ambadran/UPS/digital_design/Circuit/WhatsApp Image 2024-04-24 at 7.43.00 PM.jpeg

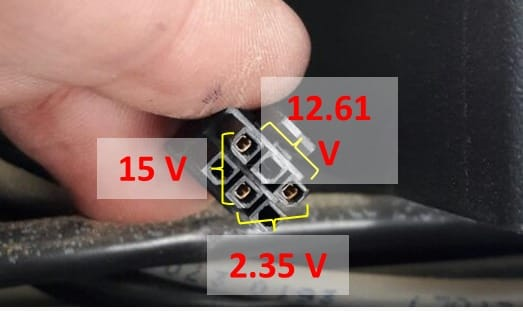
digital_design/Circuit/WhatsApp Image 2024-04-24 at 7.43.00 PM.jpeg
