ambadran/UPS/analogue_design/media/control_circuit_nand.jpeg

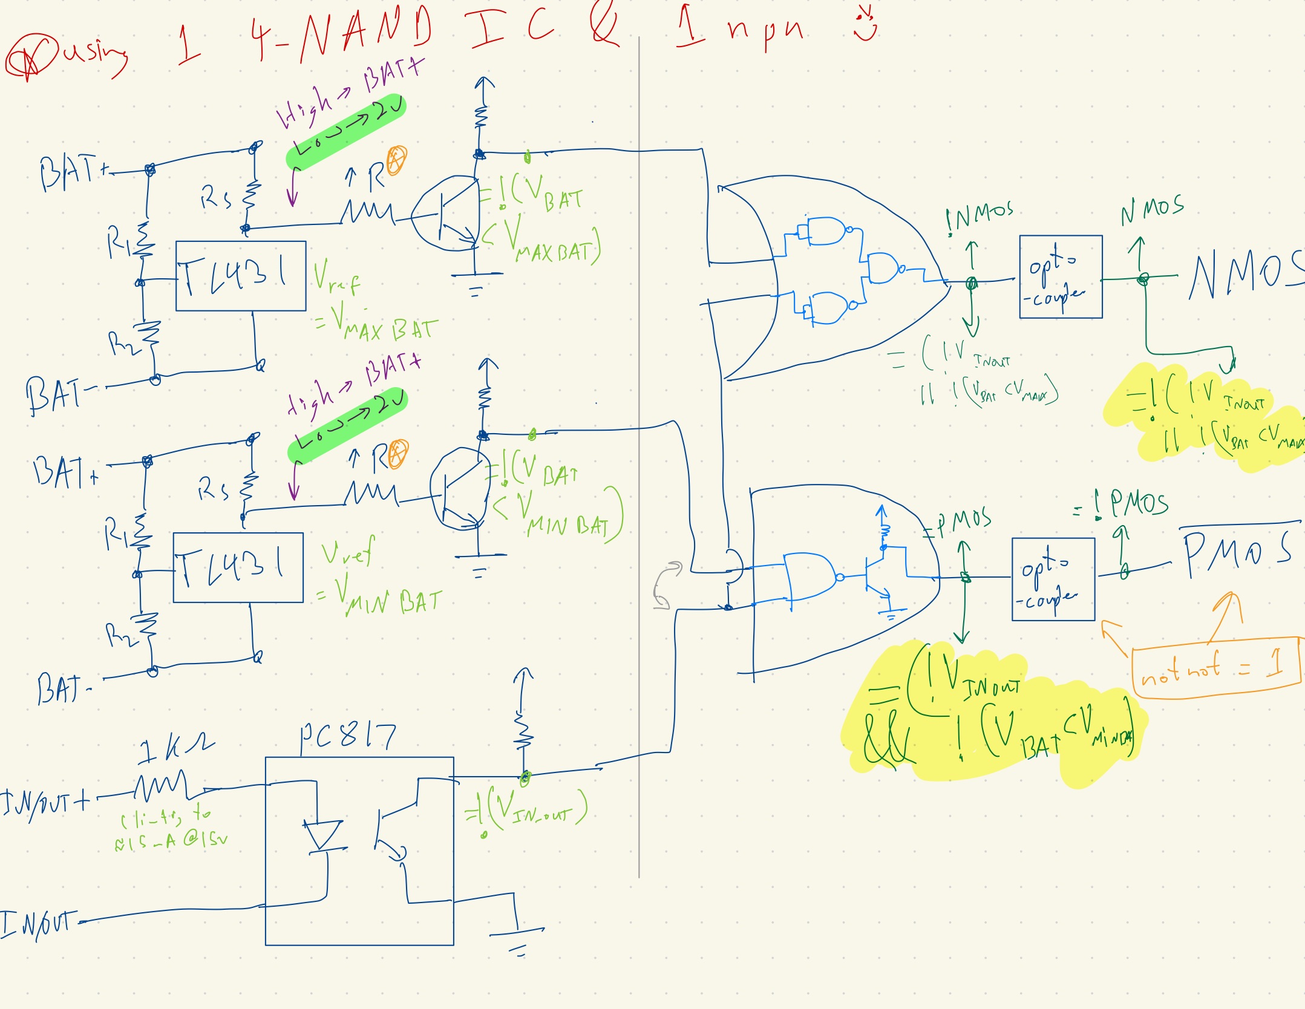
analogue_design/media/control_circuit_nand.jpeg
