ambadran/UPS/analogue_design/media/Control_circuit_npn.jpeg

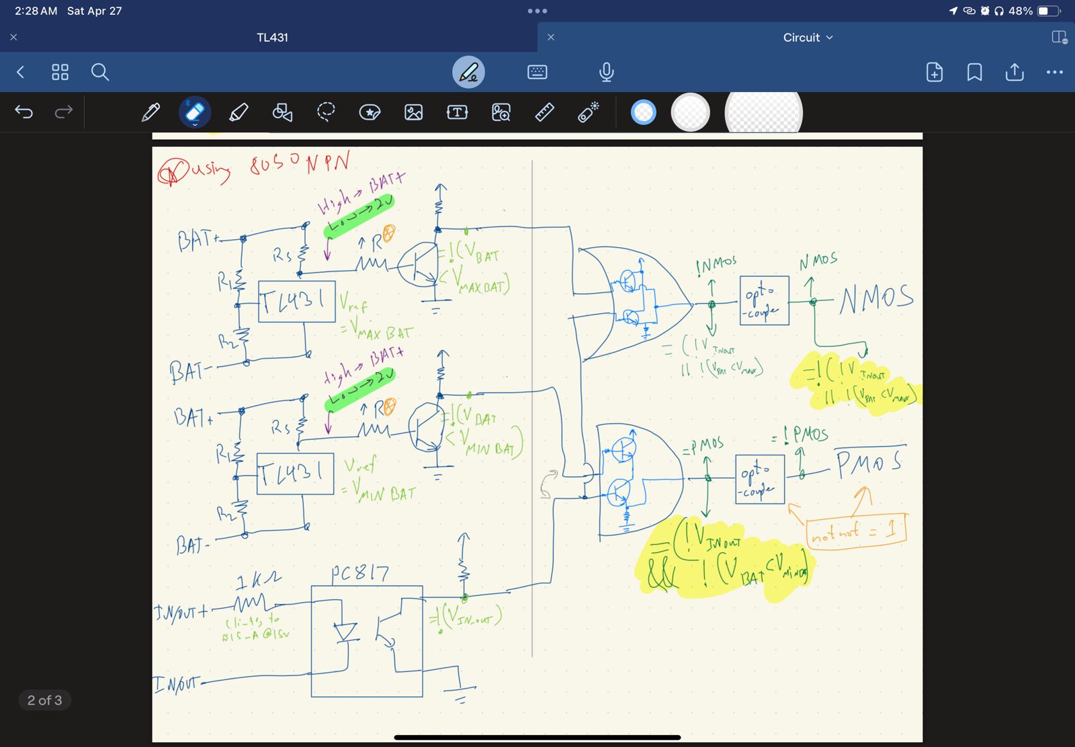
analogue_design/media/Control_circuit_npn.jpeg
