ambadran/UPS/analogue_design/media/Main Idea.png

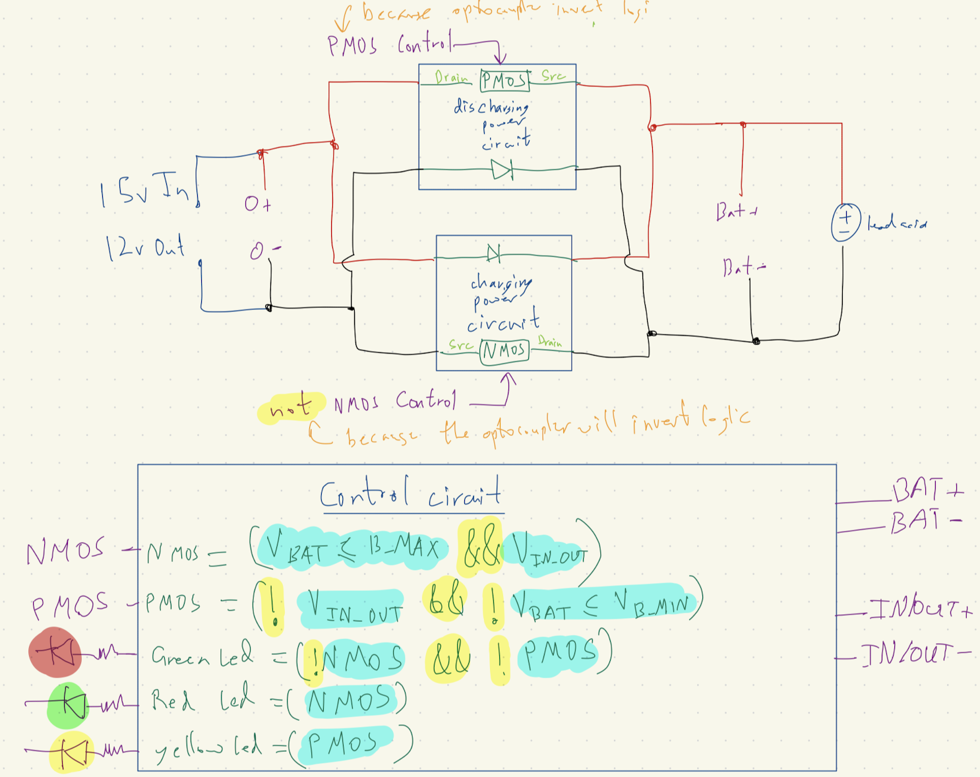
analogue_design/media/Main Idea.png
