ambadran/UPS/analogue_design/media/WhatsApp Image 2024-04-29 at 7.11.07 PM.jpeg

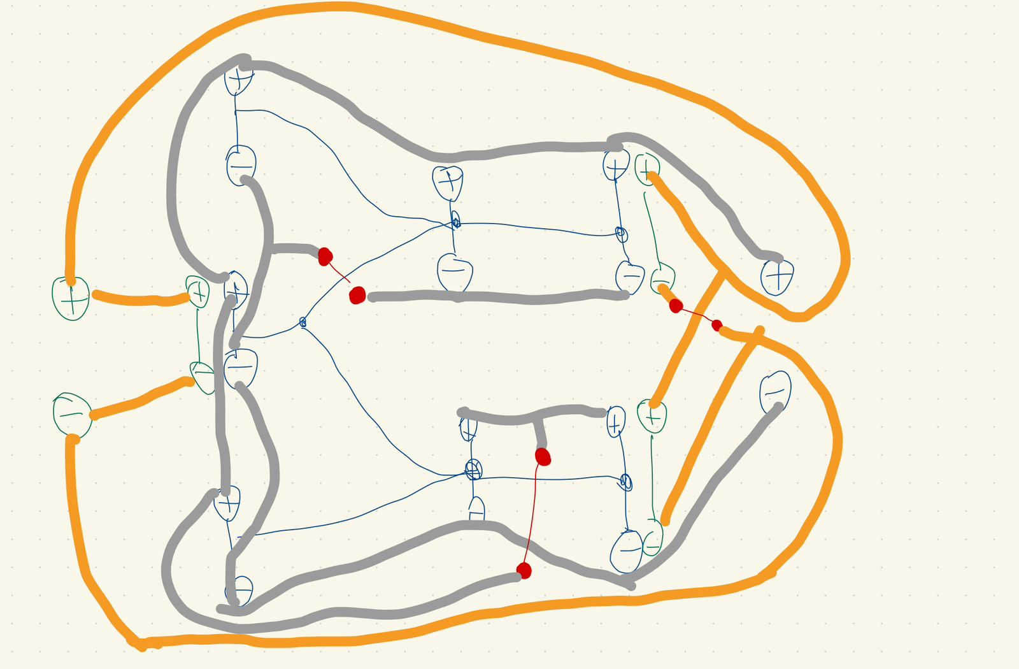
analogue_design/media/WhatsApp Image 2024-04-29 at 7.11.07 PM.jpeg
