ambadran/UPS/digital_design/Circuit/BOM/Board_BOM.xlsx

Sheet: One PCB
No. | Name | Cost | Quantity | Total Cost | Description | Store
1 | PCB board | 130 | 1 | 130
2 | IRFZ44n | 0 | 1 | 0 | ALREADY BOUGHT
3 | IRF9540 | 35 | 1 | 35 |  | RAM
4 | PC817 | 3 | 5 | 15 |  | UGE
5 | Resistor | 1 | 12 | 12 | 330 x6, 1K x3, 20k x1, 10k x1
6 | LM7805 | 1 | 8 | 8 |  | UGE
7 | Capacitor electrolytic | 2 | 1 | 2 | 10uf
8 | Capacitor ceramic | 1 | 1 | 1 | 10nf
9 | STC15W408AS DIP16 | 51 | 1 | 51
10 | RJ45 | 20 | 2 | 40 |  | fares
11 | RGB led | 5 | 1 | 5 |  | UGE
12 | RGB 3d printed mount | 15 | 1 | 15 | 3d printed
13 | 10 turn pot 500ohm | 10 | 1 | 10
14 | SR360 | 3 | 2 | 6 |  | future
15 | 1mm power wires/m | 6 | 0.3 | 1.8 | for battery output and led extension
16 | Pin Headers | 5 | 1 | 5 | for debug pins
17 | Power pin header 3d printed | 10 | 1 | 10
18 | female pin header E508 | 1 | 3 | 3
19 | 6-pin 3d printed connector | 20 | 2 | 40
20 | Battery crimp terminals | 3 | 2 | 6
 | TOTAL |  |  | 395.8

Sheet: Sheet1
No. | Name | Cost | Quantity | Total Cost | Description | Store
1 | Complete Soldered PCB | 395.8 | 17 | 6728.6
 |  |  |  | 0
<> | Design, testing and manufacturing | 6000 | 1 | 6000
 | TOTAL |  |  | 12728.6
