ambadran/UPS/digital_design/Circuit/BOM/Total.xlsx

No. | Name | Cost | Quantity | Total Cost
1 | Complete PCB | 395.8 | 17 | 6728.6
<> | Design, Testing and manufacturing | 35 | 1 | 7000
 | TOTAL |  |  | 13728.6
