ambadran/UPS/analogue_design/PDF/back.pdf

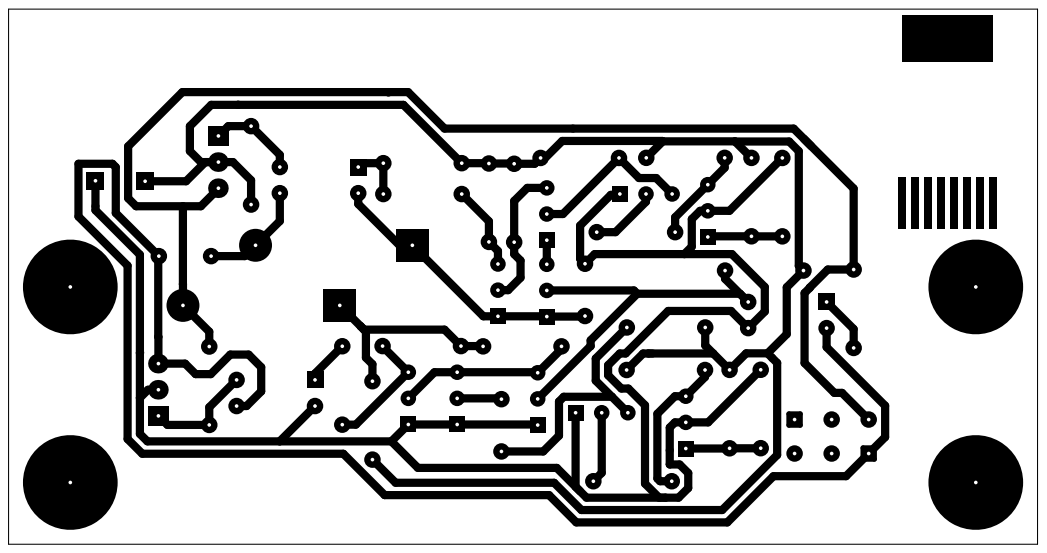
[picture p6: page 1]
