ambadran/UPS/analogue_design/PDF/front.pdf

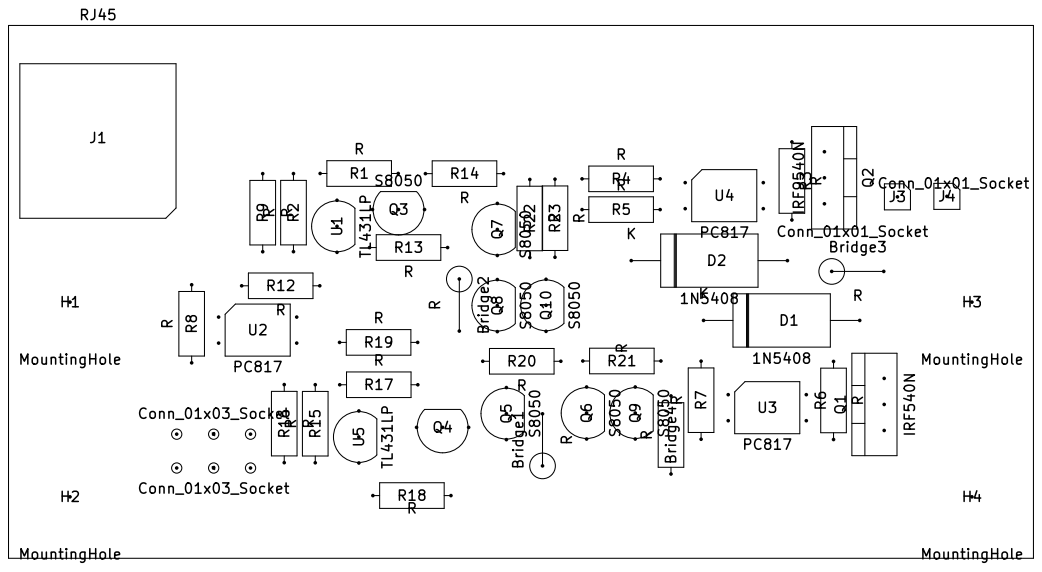
[picture p7: page 1]
