ambadran/UPS/digital_design/Circuit/PDF/back.pdf

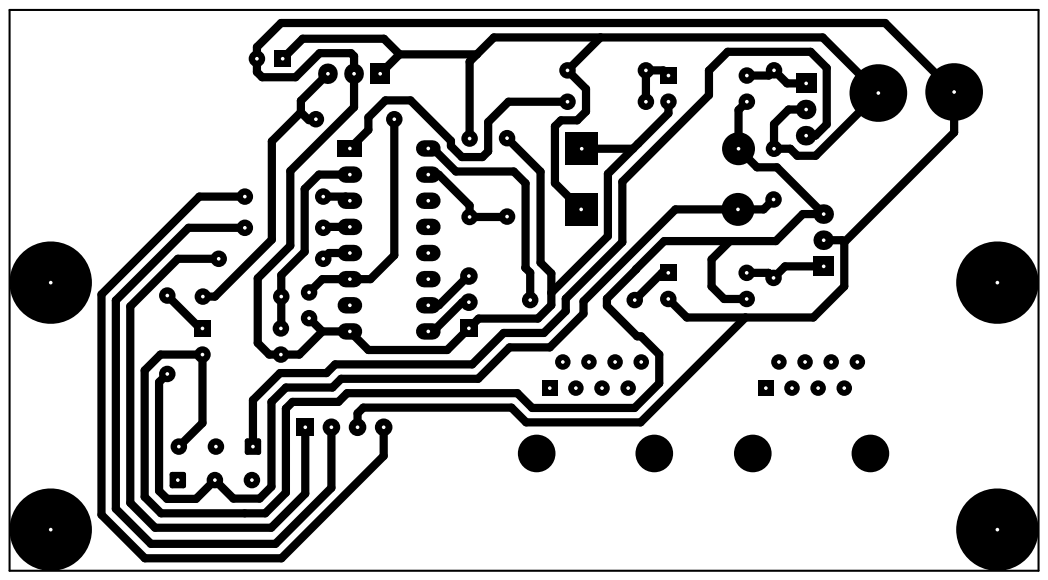
[picture p8: page 1]
