ambadran/UPS/digital_design/Circuit/PDF/front.pdf

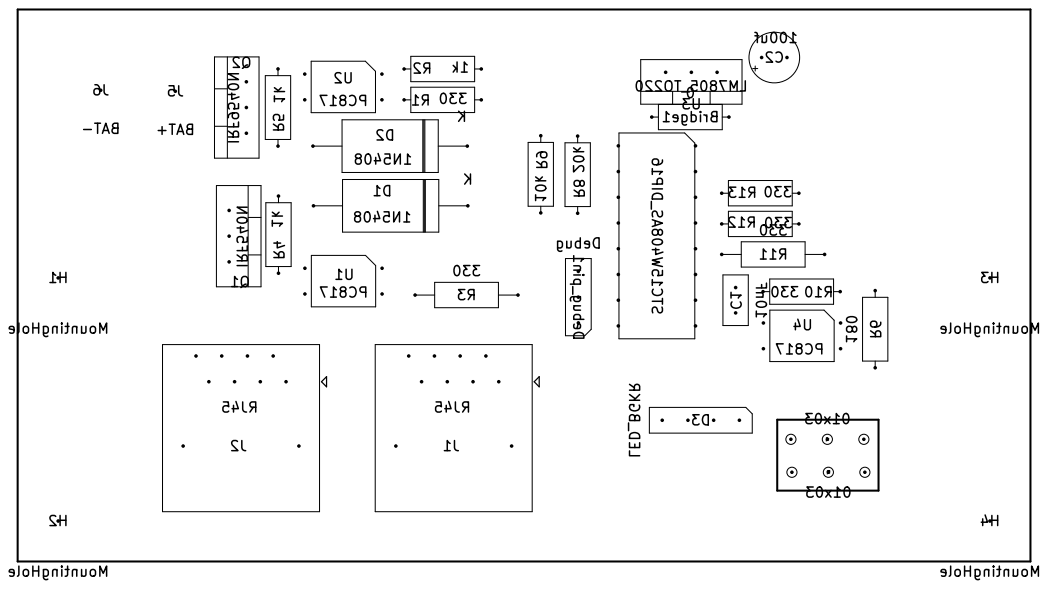
[picture p9: page 1]
