ambadran/UPS/digital_design/Circuit/PDF/ups.pdf

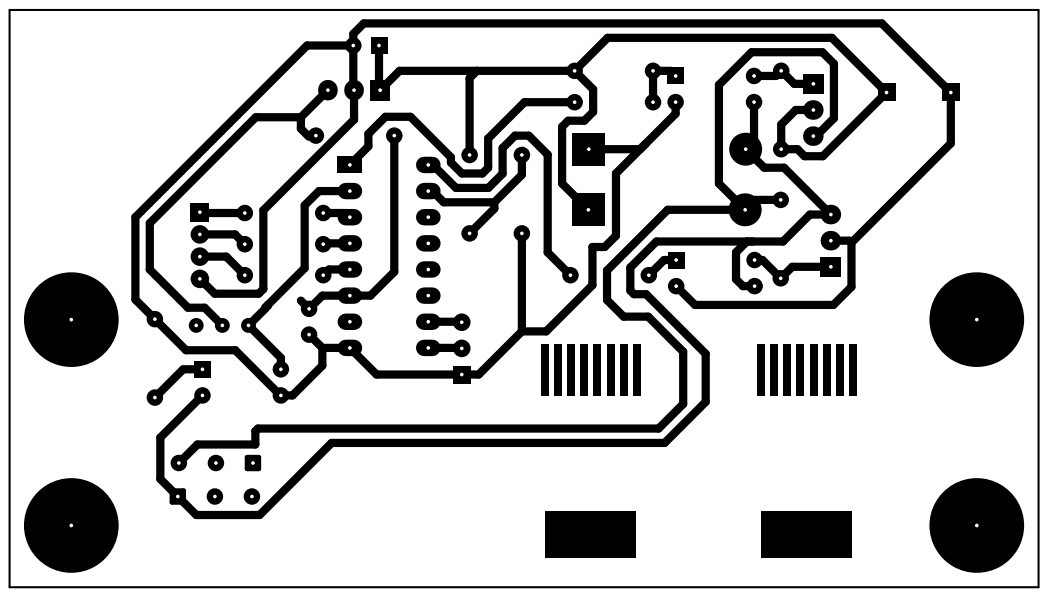
[picture p10: page 1]
