ambadran/UPS/digital_design/Circuit/Circuit.kicad_pcb

## KiCad design digital_design/Circuit/Circuit.kicad_pcb (2024-08-04)

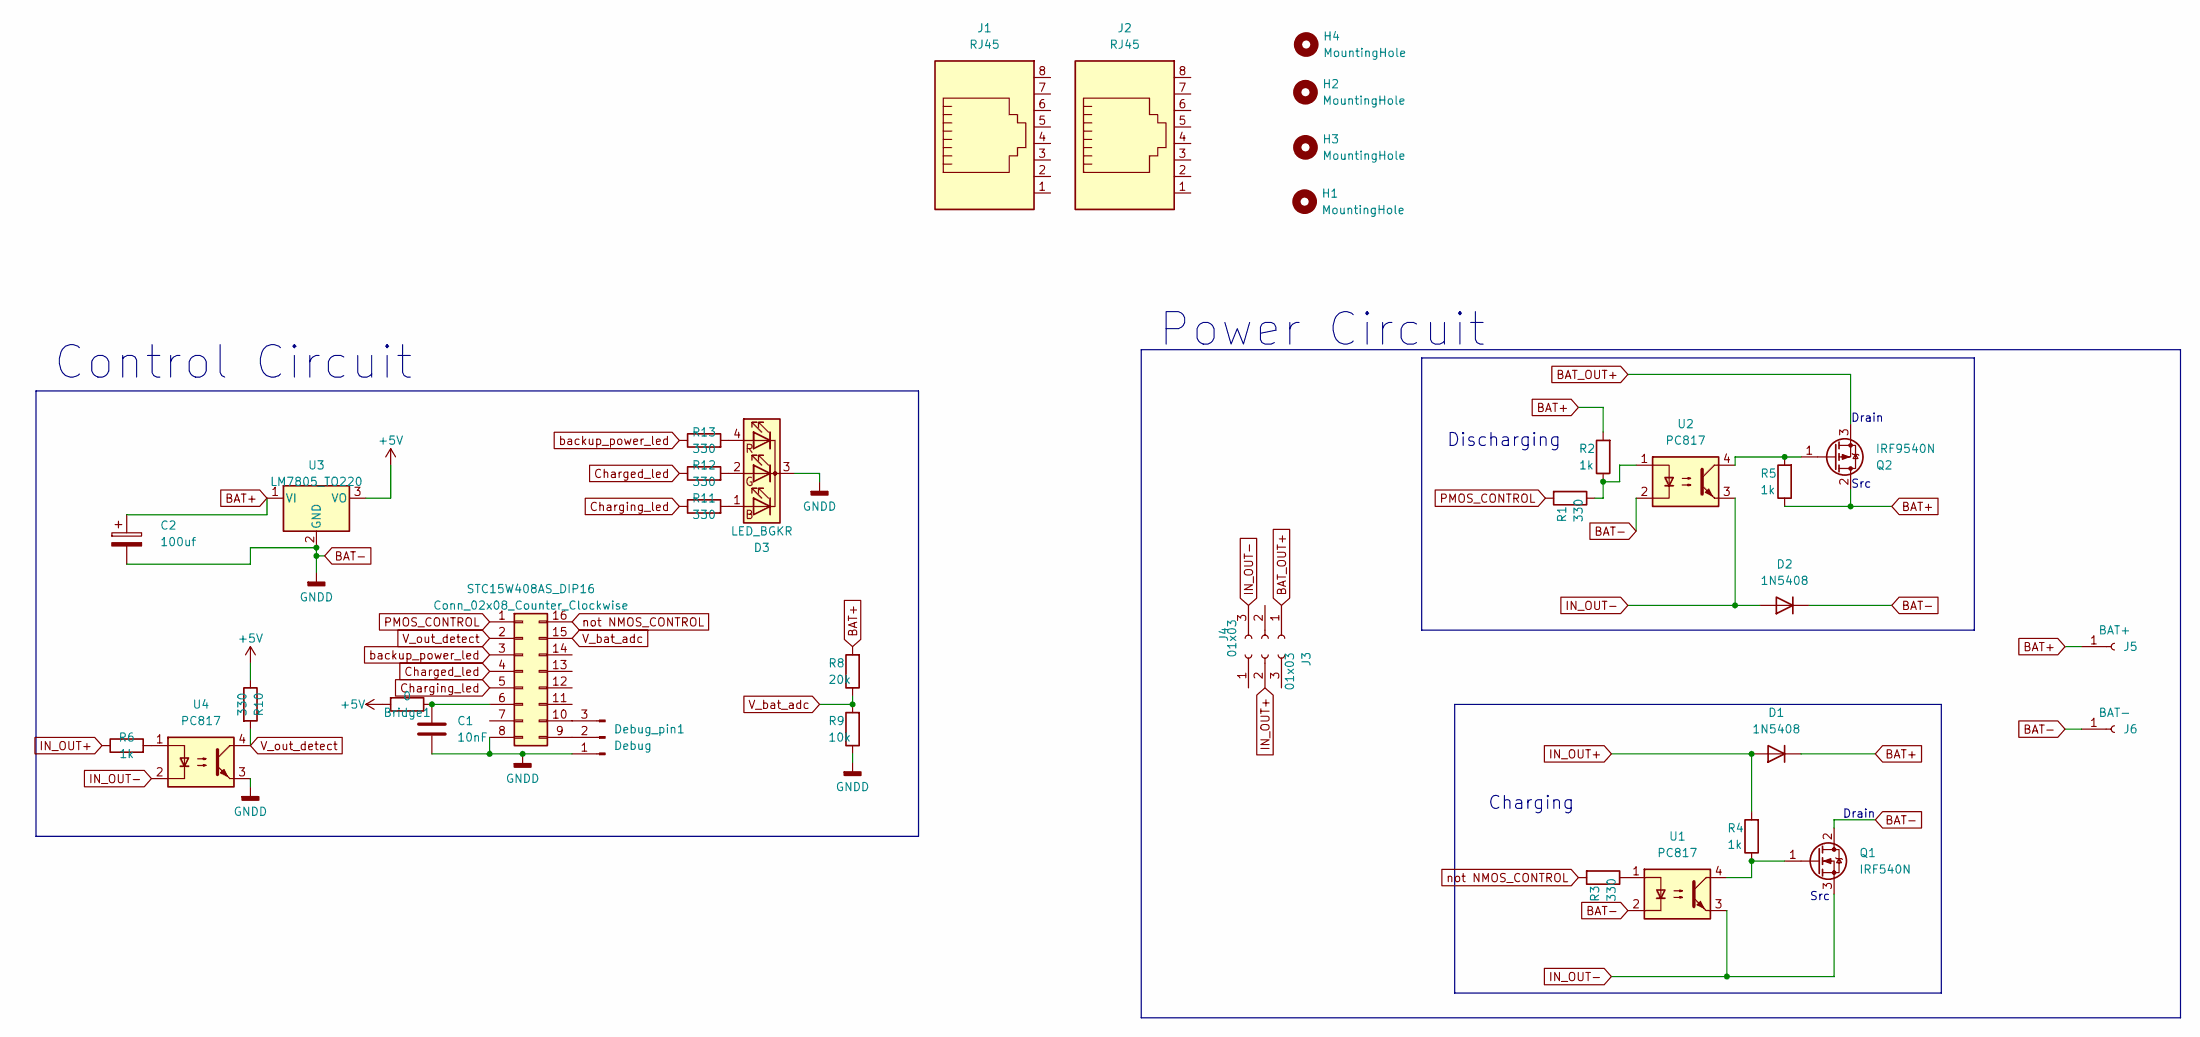
[picture p11: schematic Circuit.kicad_sch]

Parts:
Bridge1: 0; R_Axial_DIN0207_L6.3mm_D2.5mm_P7.62mm_Horizontal
C1: 10nF; C_Disc_D5.0mm_W2.5mm_P2.50mm
C2: 100uf; CP_Radial_D5.0mm_P2.50mm
D1, D2: 1N5408; D_DO-201AD_P15.24mm_Horizontal
D3: LED_BGKR; PinSocket_1x04_P2.54mm_Vertical
Debug_pin1: Debug; PinSocket_1x03_P2.54mm_Vertical
H1, H2, H3, H4: MountingHole; MountingHole_4mm_Pad_TopBottom
J1, J2: RJ45; RJ45_OST_PJ012-8P8CX_Vertical
J3, J4: 01x03; SolderWire-0.1sqmm_1x03_P3.6mm_D0.4mm_OD1mm
J5: BAT+; MountingHole_3.2mm_M3_DIN965_Pad_TopBottom
J6: BAT-; MountingHole_3.2mm_M3_DIN965_Pad_TopBottom
Q1: IRF540N; TO-220-3_Vertical
Q2: IRF9540N; TO-220-3_Vertical
R1, R10, R12, R13: 330; R_Axial_DIN0207_L6.3mm_D2.5mm_P7.62mm_Horizontal
R2, R4, R5, R6: 1k; R_Axial_DIN0207_L6.3mm_D2.5mm_P7.62mm_Horizontal
R3, R11: 330; R_Axial_DIN0207_L6.3mm_D2.5mm_P10.16mm_Horizontal
R8: 20k; R_Axial_DIN0207_L6.3mm_D2.5mm_P7.62mm_Horizontal
R9: 10k; R_Axial_DIN0207_L6.3mm_D2.5mm_P7.62mm_Horizontal
STC15W408AS_DIP16: Conn_02x08_Counter_Clockwise; CERDIP-16_W7.62mm_SideBrazed_LongPads
U1, U2, U4: PC817; DIP-4_W7.62mm
U3: LM7805_TO220; TO-220-3_Vertical

Connections:
+5V: Bridge1.2, R10.1, U3.3 (VO)
BAT+: C2.1, D1.1 (K), J5.1, Q2.2 (D), R2.2, R5.1, R8.2, U3.1 (VI)
BAT-: C1.2, C2.2, D2.1 (K), D3.3 (K), Debug_pin1.1, J6.1, Q1.2 (D), R9.1, STC15W408AS_DIP16.8, U1.2, U2.2, U3.2 (GND), U4.3
BAT_OUT+: J4.1, Q2.3 (S)
Charged_led: R12.1, STC15W408AS_DIP16.4
Charging_led: R11.1, STC15W408AS_DIP16.5
IN_OUT+: D1.2 (A), J3.2, R4.2, R6.1
IN_OUT-: D2.2 (A), J4.3, Q1.3 (S), U1.3, U2.3, U4.2
unnamed: D3.1 (BA), R11.2
unnamed: D3.2 (GA), R12.2
unnamed: D3.4 (RA), R13.2
unnamed: Debug_pin1.2, STC15W408AS_DIP16.9
unnamed: Debug_pin1.3, STC15W408AS_DIP16.10
unnamed: Q1.1 (G), R4.1, U1.4
unnamed: Q2.1 (G), R5.2, U2.4
unnamed: R1.1, R2.1, U2.1
unnamed: R3.1, U1.1
unnamed: R6.2, U4.1
unnamed: Bridge1.1, C1.1, STC15W408AS_DIP16.6
PMOS_CONTROL: R1.2, STC15W408AS_DIP16.1
V_bat_adc: R8.1, R9.2, STC15W408AS_DIP16.15
V_out_detect: R10.2, STC15W408AS_DIP16.2, U4.4
backup_power_led: R13.1, STC15W408AS_DIP16.3
not NMOS_CONTROL: R3.2, STC15W408AS_DIP16.16

Notes on the sheet:
Src
Power Circuit
Drain
Control Circuit
Discharging
Charging

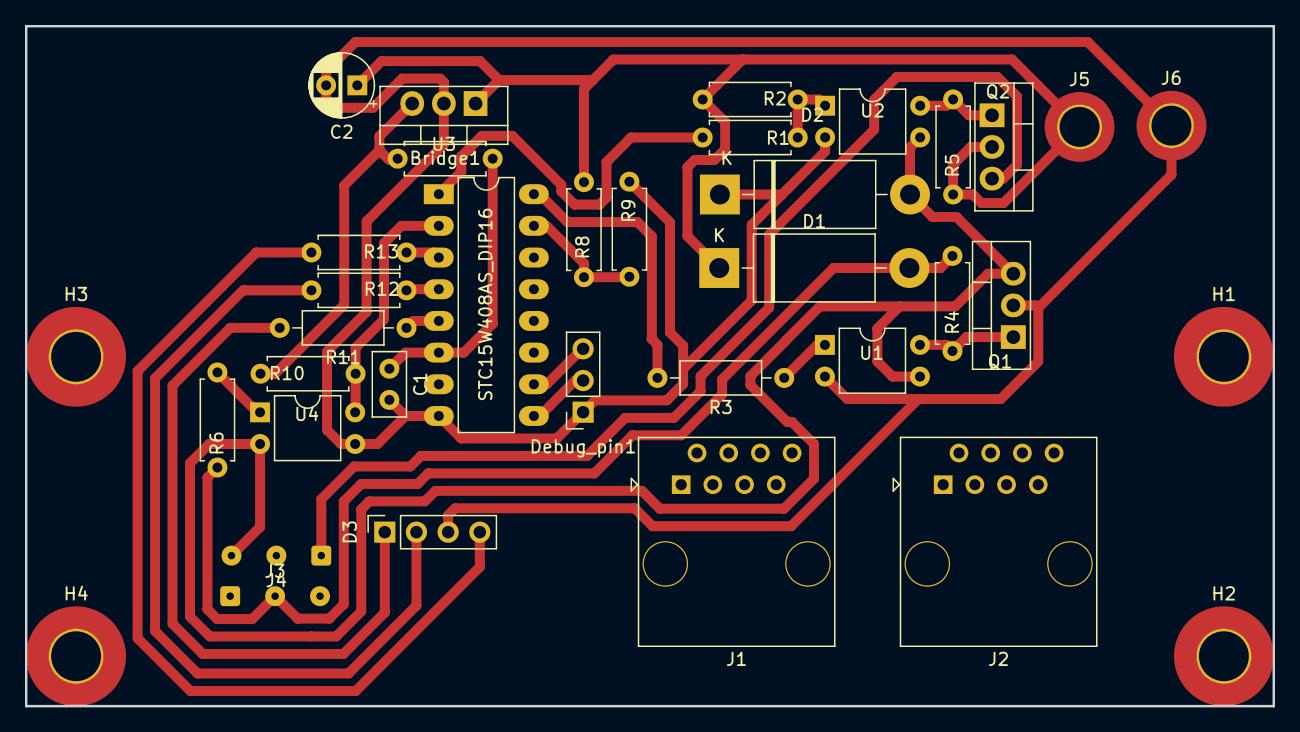
[picture p12: board Circuit.kicad_pcb from above]

Board: 2 copper layers, 100.0 x 54.5 mm, 36 parts (0 on the bottom side), 24 nets.
