ambadran/UPS/analogue_design/auto_cutoff_battery.kicad_pcb

## KiCad design analogue_design/auto_cutoff_battery.kicad_pcb (2024-05-02)

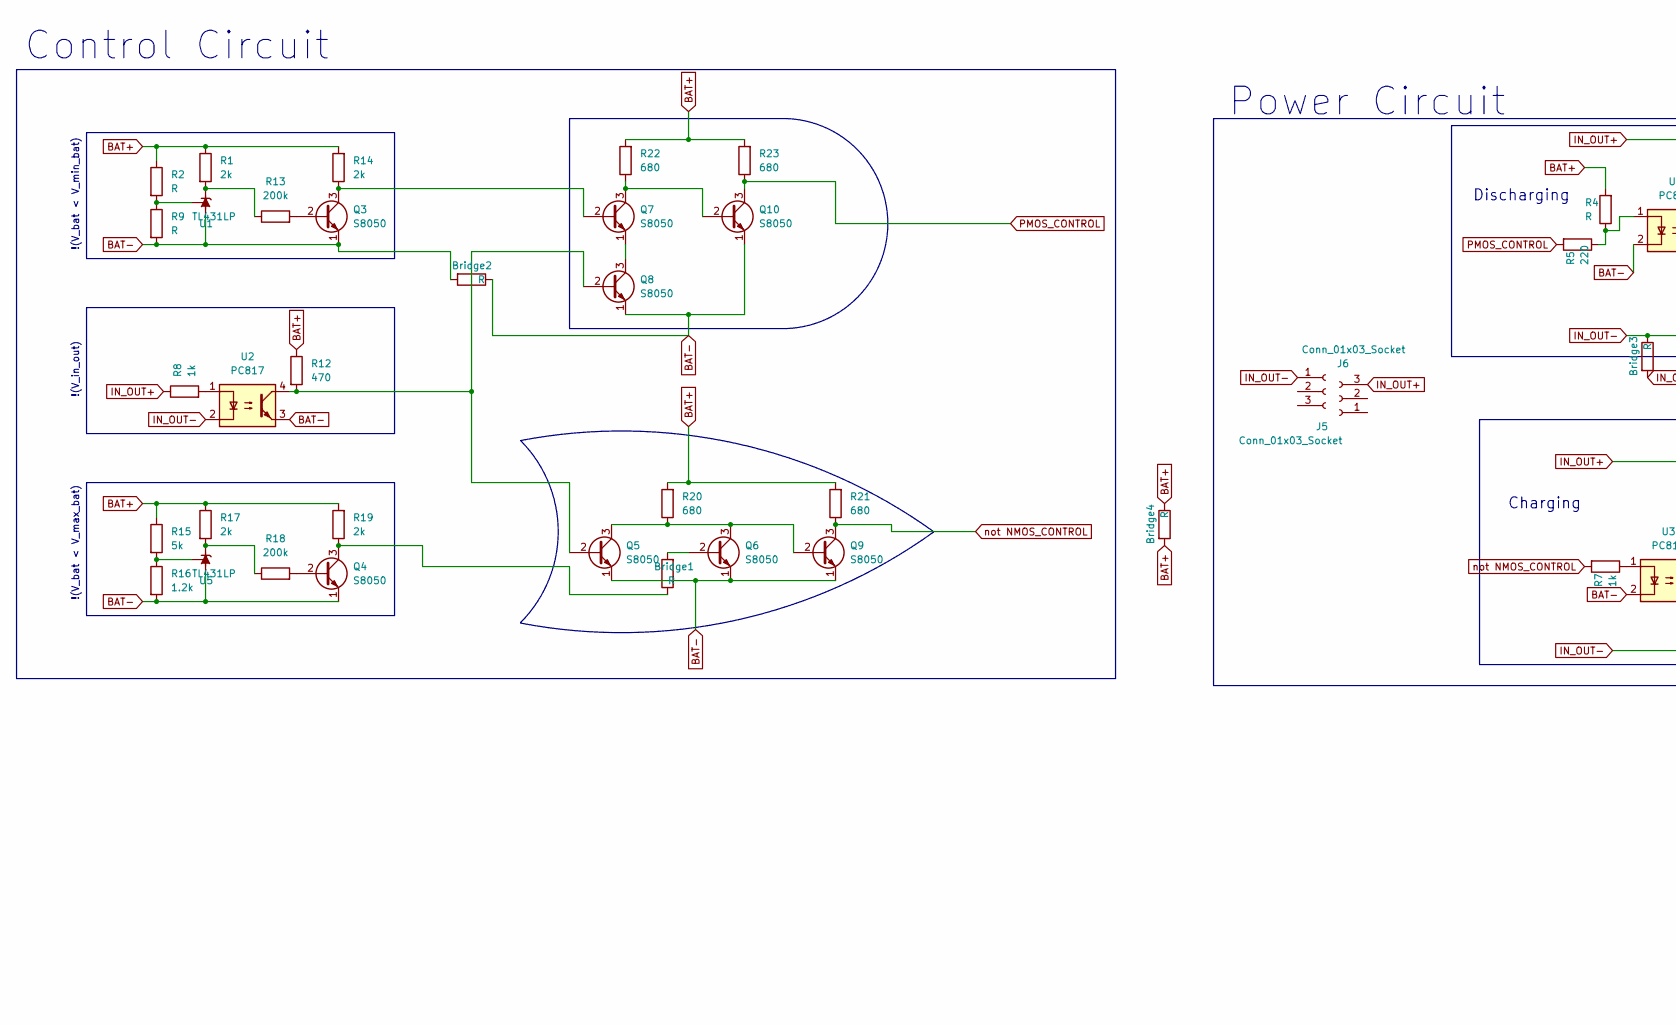
[picture p13: schematic auto_cutoff_battery.kicad_sch, part in row 1, column 1]

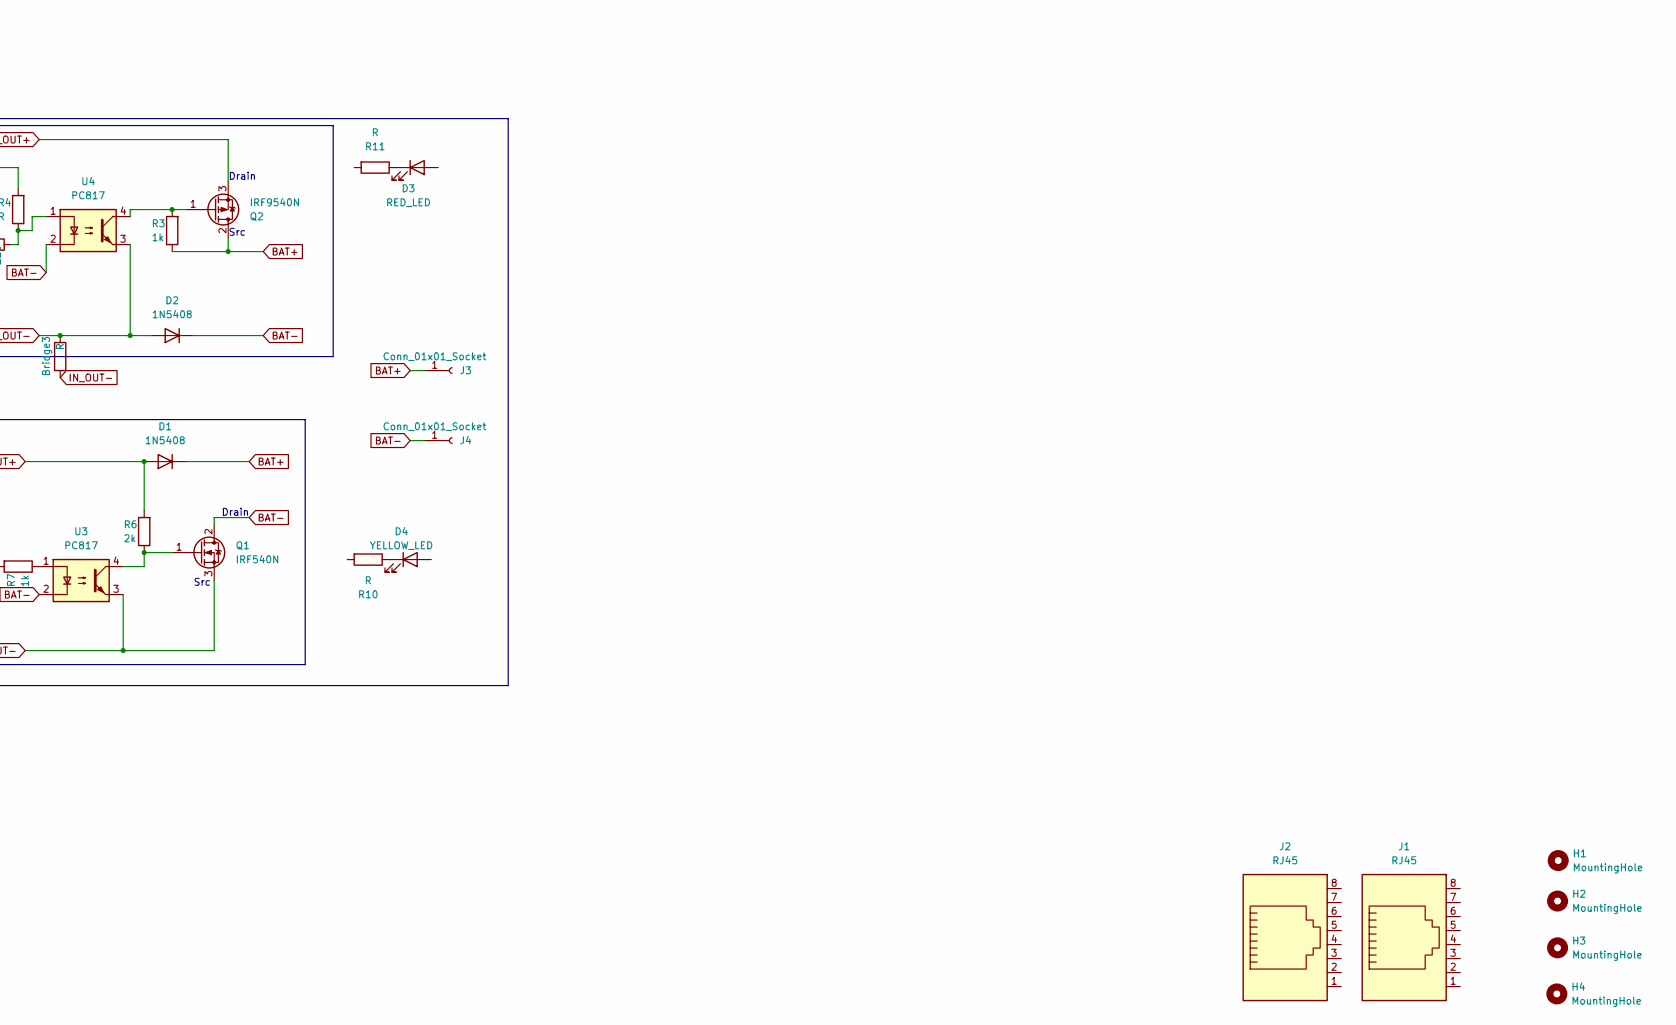
[picture p14: schematic auto_cutoff_battery.kicad_sch, part in row 1, column 2]

Parts:
Bridge1, Bridge2, Bridge3: R; R_Axial_DIN0207_L6.3mm_D2.5mm_P5.08mm_Vertical
Bridge4: R; R_Axial_DIN0207_L6.3mm_D2.5mm_P7.62mm_Horizontal
D1, D2: 1N5408; D_DO-201AD_P15.24mm_Horizontal
D3: RED_LED; LED_D3.0mm
D4: YELLOW_LED; LED_D3.0mm
H1, H2, H3, H4: MountingHole; MountingHole_5.3mm_M5_DIN965_Pad
J1, J2: RJ45; RJ45_Molex_0855135013_Vertical
J3, J4: Conn_01x01_Socket; PinSocket_1x01_P2.54mm_Vertical
J5, J6: Conn_01x03_Socket; SolderWire-0.1sqmm_1x03_P3.6mm_D0.4mm_OD1mm
Q1: IRF540N; TO-220-3_Vertical
Q2: IRF9540N; TO-220-3_Vertical
Q3, Q4, Q5, Q6, Q7, Q8, Q9, Q10: S8050; TO-92_Inline_Wide
R1, R6, R14, R17, R19: 2k; R_Axial_DIN0207_L6.3mm_D2.5mm_P7.62mm_Horizontal
R2, R4, R9, R10, R11: R; R_Axial_DIN0207_L6.3mm_D2.5mm_P7.62mm_Horizontal
R3, R7, R8: 1k; R_Axial_DIN0207_L6.3mm_D2.5mm_P7.62mm_Horizontal
R5: 220; R_Axial_DIN0207_L6.3mm_D2.5mm_P7.62mm_Horizontal
R12: 470; R_Axial_DIN0207_L6.3mm_D2.5mm_P7.62mm_Horizontal
R13, R18: 200k; R_Axial_DIN0207_L6.3mm_D2.5mm_P7.62mm_Horizontal
R15: 5k; R_Axial_DIN0207_L6.3mm_D2.5mm_P7.62mm_Horizontal
R16: 1.2k; R_Axial_DIN0207_L6.3mm_D2.5mm_P7.62mm_Horizontal
R20, R21, R22, R23: 680; R_Axial_DIN0207_L6.3mm_D2.5mm_P7.62mm_Horizontal
U1, U5: TL431LP; TO-92_Inline_Wide
U2, U3, U4: PC817; DIP-4_W7.62mm

Connections:
BAT+: Bridge4.1, Bridge4.2, D1.1 (K), J3.1, Q2.2 (D), R1.1, R2.1, R3.1, R4.2, R12.1, R14.2, R15.1, R17.1, R19.2, R20.2, R21.2, R22.2, R23.2
BAT-: Bridge2.1, Bridge2.2, D2.1 (K), J4.1, Q1.2 (D), Q3.1 (E), Q4.1 (E), Q5.1 (E), Q6.1 (E), Q8.1 (E), Q9.1 (E), Q10.1 (E), R9.2, R16.2, U1.2 (A), U2.3, U3.2, U4.2, U5.2 (A)
IN_OUT+: D1.2 (A), J6.3, Q2.3 (S), R6.2, R8.1
IN_OUT-: Bridge3.1, Bridge3.2, D2.2 (A), J5.1, Q1.3 (S), U2.2, U3.3, U4.3
unnamed: D3.1 (K), R11.1
unnamed: D4.1 (K), R10.1
unnamed: Q1.1 (G), R6.1, U3.4
unnamed: Q2.1 (G), R3.2, U4.4
unnamed: Q3.2 (B), R13.2
unnamed: Q3.3 (C), Q7.2 (B), R14.1
unnamed: Q4.2 (B), R18.2
unnamed: Bridge1.1, Q4.3 (C), R19.1
unnamed: Q5.2 (B), Q8.2 (B), R12.2, U2.4
unnamed: Q5.3 (C), Q6.3 (C), Q9.2 (B), R20.1
unnamed: Bridge1.2, Q6.2 (B)
unnamed: Q7.1 (E), Q8.3 (C)
unnamed: Q7.3 (C), Q10.2 (B), R22.1
unnamed: R4.1, R5.1, U4.1
unnamed: R7.1, U3.1
unnamed: R8.2, U2.1
unnamed: R1.2, R13.1, U1.3 (K)
unnamed: R2.2, R9.1, U1.1 (REF)
unnamed: R17.2, R18.1, U5.3 (K)
unnamed: R15.2, R16.1, U5.1 (REF)
PMOS_CONTROL: Q10.3 (C), R5.2, R23.1
not NMOS_CONTROL: Q9.3 (C), R7.2, R21.1

Notes on the sheet:
Discharging
Drain
Control Circuit
Src
!(V_bat < V_min_bat)
Charging
!(V_in_out)
Power Circuit
!(V_bat < V_max_bat)

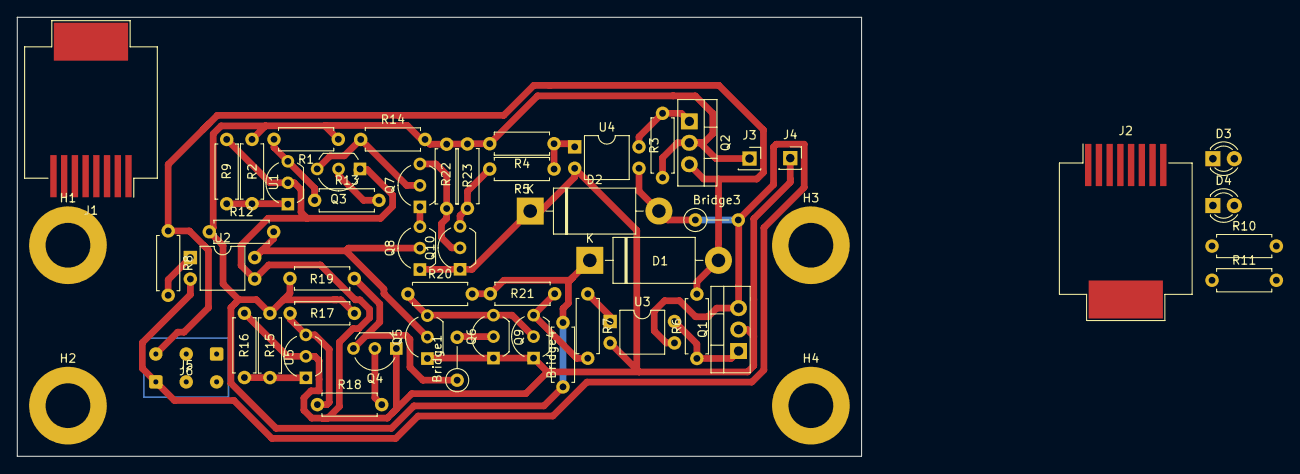
[picture p15: board auto_cutoff_battery.kicad_pcb from above]

Board: 2 copper layers, 100.0 x 52.0 mm, 55 parts (0 on the bottom side), 26 nets.
