ambadran/UPS/(commit log)

2024-04-26 added digital circuit schematic
    [auto_cutoff_battery.kicad_pcb, auto_cutoff_battery.kicad_sch]
2024-04-26 minor change in power electronics schematic
    [auto_cutoff_battery.kicad_sch]
2024-04-27 minor changes
    [auto_cutoff_battery.kicad_sch]
2024-04-27 started PCB design
    [auto_cutoff_battery.kicad_pcb, auto_cutoff_battery.kicad_sch]
2024-04-28 finished PCB solution
    [auto_cutoff_battery.kicad_pcb, auto_cutoff_battery.kicad_sch]
2024-04-29 started final design
    [ups.kicad_pcb, ups.kicad_sch]
2024-04-29 finished PCB and added gcode files
    [auto_cutoff_battery.kicad_pcb, auto_cutoff_battery.kicad_sch, ups.kicad_pcb, ups.kicad_sch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]
2024-05-01 added resistor values
    [auto_cutoff_battery.csv, auto_cutoff_battery.kicad_pcb, auto_cutoff_battery.kicad_sch]
2024-05-02 finished V1
    [Circuit.csv, Circuit.kicad_pcb, Circuit.kicad_sch, auto_cutoff_battery.csv, auto_cutoff_battery.kicad_pcb, auto_cutoff_battery.kicad_sch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]
2024-05-02 added final BOM
    [BOM.xlsx]
2024-05-06 started updating
    [Circuit.kicad_sch]
2024-05-07 Updated Design as per requirement
    [Circuit.kicad_pcb, Circuit.kicad_sch]
2024-05-10 changed holes footprint
    [Circuit.csv, Circuit.kicad_pcb, Circuit.kicad_sch]
